open-tags/opentag-U1/hardware/v2_final_part_list.csv

Comment | Designator | Footprint | JLCPCB Part # | Qty | Ext.Price($)
LED | D14,D5,D7,D8,D9 | 0402 | C965793 | 62 | 0.49
AP2112K-3.3 | U4 | SOT-23-5 | C23380830 | 12 | 1.29
Si2319CDS | Q1 | SOT-23 | C5122036 | 12 | 1.11
511k | R5 | 0402 | C64042 | 20 | 0.02
SW_Push | SW1,SW2 | SW_SPST_EVQP2_ShortPushTravel_H2.1mm | C79161 | 20 | 7.51
BZT52Bxx | D13 | D_SOD-123F | C282531 | 14 | 0.63
105k | R4 | 0402 | C25742 | 20 | 0.01
LED | D15 | 0402 | C25503345 | 22 | 0.18
LED | D10 | 0402 | C25503856 | 20 | 0.26
Conn_ARM_JTAG_SWD_10 | J1 | PinHeader_2x05_P1.27mm_Vertical_SMD | C42372555 | 10 | 1.91
22u | C10,C9 | 0402 | C3845593 | 21 | 2.95
LED | D11,D12 | 0402 | C20613596 | 32 | 0.36
SP0503BAHTG | D2 | SOT-143 | C3040626 | 12 | 1.13
10u | C16,C3 | 0402 | C315248 | 32 | 0.29
120 | R20 | 0402 | C25079 | 20 | 0.02
10u | L1 | L_Sunlord_MWSA0503S | C408412 | 12 | 2.03
75p | C11 | 0402 | C107010 | 20 | 0.02
TPS54302 | U3 | SOT-23-6 | C311983 | 10 | 2.44
USB_C_Receptacle_USB2.0_16P | J3 | USB_C_Receptacle_XKB_U262-16XN-4BVC11 | C319148 | 10 | 3.70
SS14 | D3,D4 | D_SMA | C2480 | 30 | 0.50
100k | R3,R7,R9 | 0402 | C25530 | 40 | 0.03
1k | R10,R11,R12,R13,R14,R15,R16,R17,R21,R22 | 0402 | C11702 | 110 | 0.11
1u | C4,C7,C8 | 0402 | C1518208 | 34 | 1.03
49.9 | R6 | 0402 | C325388 | 20 | 0.05
13.3k | R8 | 0402 | C122547 | 20 | 0.02
5.1k | R1,R2 | 0402 | C25905 | 30 | 0.03
SW_Push | SW3 | THS101J | C2758165 | 10 | 5.99
Crystal_GND24 | Y2 | Crystal_SMD_Abracon_ABM3B-4Pin_5.0x3.2mm | C276420 | 10 | 6.18
14p | C12,C13 | 0402 | C458857 | 30 | 0.06
TCAN1044VDRQ1 | U1 | SOIC-8_3.9x4.9mm_P1.27mm | C1852061 | 10 | 3.39
100n | C17,C21,C5,C6,C14,C15,C18,C19,C2,C20 | 0402 | C307331 | 110 | 0.46
10k | R18,R19 | 0402 | C25744 | 30 | 0.04
STM32G474CCTx | U5 | LQFP-48_7x7mm_P0.5mm | C730124 | 10 | 29.39
