open-tags/opentag-U1/mechanical/opentag_one_v2_full_assembly.step

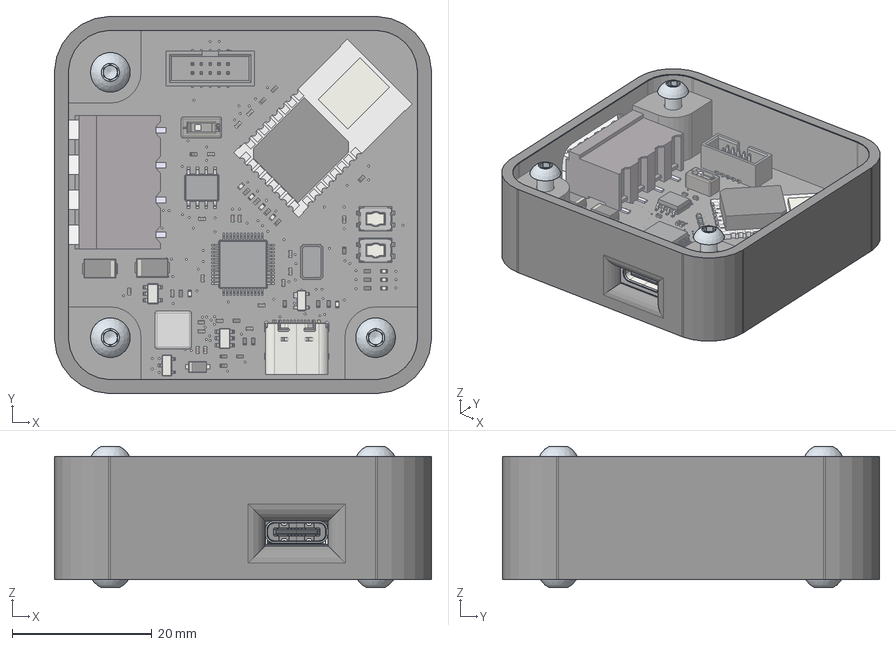
[picture p2: CAD file, 2026-10-29]
mechanical/opentag_one_v2_full_assembly.step
54.0 x 54.0 x 20.2 mm
USB_C_Receptacle_GCT_USB4105-xx-A_16P_TopMnt_Horizontal x 36
DWM1000
C_0402_1005Metric_1
R_0402_1005Metric_11
v2 1.28.1 x 3
SOT-23-5
802-2195SM-XXG_3
802-2195SM-XXG_9
C_0402_1005Metric_11
C_0402_1005Metric
SOT-143
1473790000--3DModel-STEP-764301 x 13
C_0402_1005Metric_9
802-2195SM-XXG_7
opentag_PCB
M3 Threaded Insert x 3
C_0402_1005Metric_18
Socket button head screw M3x0.5 x 6 x 3
D_SMA
C_0402_1005Metric_5
C_0402_1005Metric_2
v2_lid x 2
C_0402_1005Metric_10
Socket button head screw M3x0.5 x 10 x 3
C_0402_1005Metric_15
802-2195SM-XXG_2
SW_SPST_EVQP2_ShortPushTravel_H2.1mm_1
LED_0402_1005Metric_6
802-2195SM-XXG
R_0402_1005Metric
C_0402_1005Metric_14
v2_case
R_0402_1005Metric_17
R_0402_1005Metric_6
C_0402_1005Metric_3
R_0402_1005Metric_4
SOT-23
C_0402_1005Metric_4
LED_0402_1005Metric
R_0402_1005Metric_7
R_0402_1005Metric_20
R_0402_1005Metric_21
802-2195SM-XXG_1
C_0402_1005Metric_8
C_0402_1005Metric_19
R_0402_1005Metric_12
R_0402_1005Metric_14
R_0402_1005Metric_15
802-2195SM-XXG_6
D_SOD-123F
LED_0402_1005Metric_3
SOIC-8_3.9x4.9mm_P1.27mm
v2 - dip_switch
C_0402_1005Metric_7
LQFP-48_7x7mm_P0.5mm
R_0402_1005Metric_3
LED_0402_1005Metric_5
802-2195SM-XXG_5
SOT-23-6
R_0402_1005Metric_8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
