open-tags/opentag-U1/mechanical/opentag_one_v2_case.step

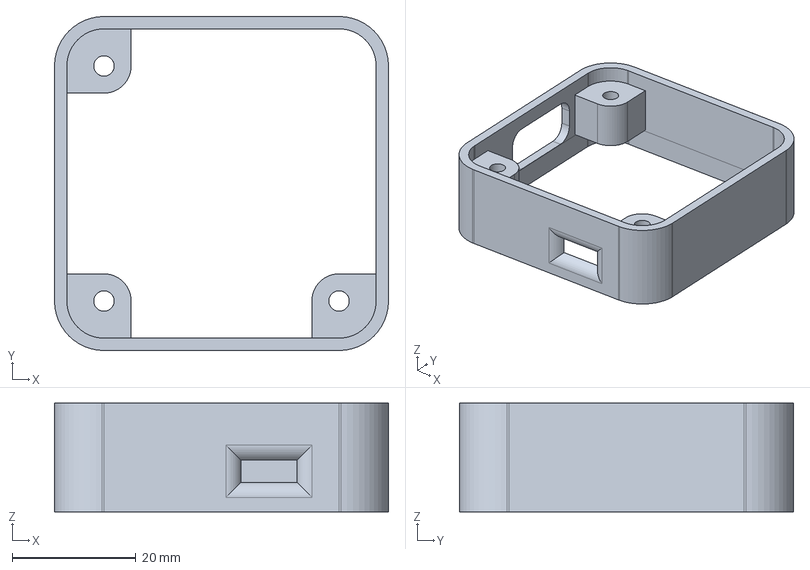
[picture p3: CAD file, 2026-10-29]
mechanical/opentag_one_v2_case.step
54.0 x 54.0 x 17.6 mm
