open-tags/opentag-U1/mechanical/opentag_one_v2_lid.step

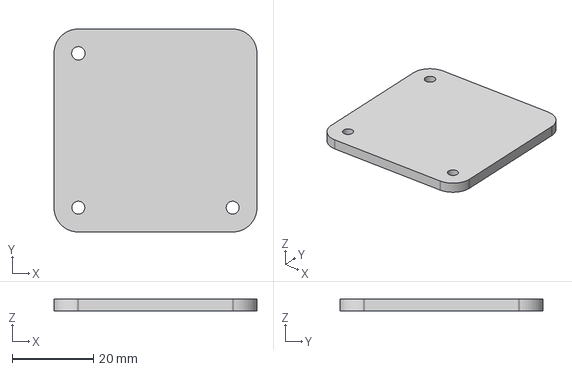
[picture p4: CAD file, 2026-10-29]
mechanical/opentag_one_v2_lid.step
50.0 x 50.0 x 3.00 mm
