open-tags/opentag-U1/(list of files, cad)

Other CAD files:
mechanical/opentag_one_v2_case.3mf
