open-tags/opentag-U1/hardware/opentag-schematic.pdf

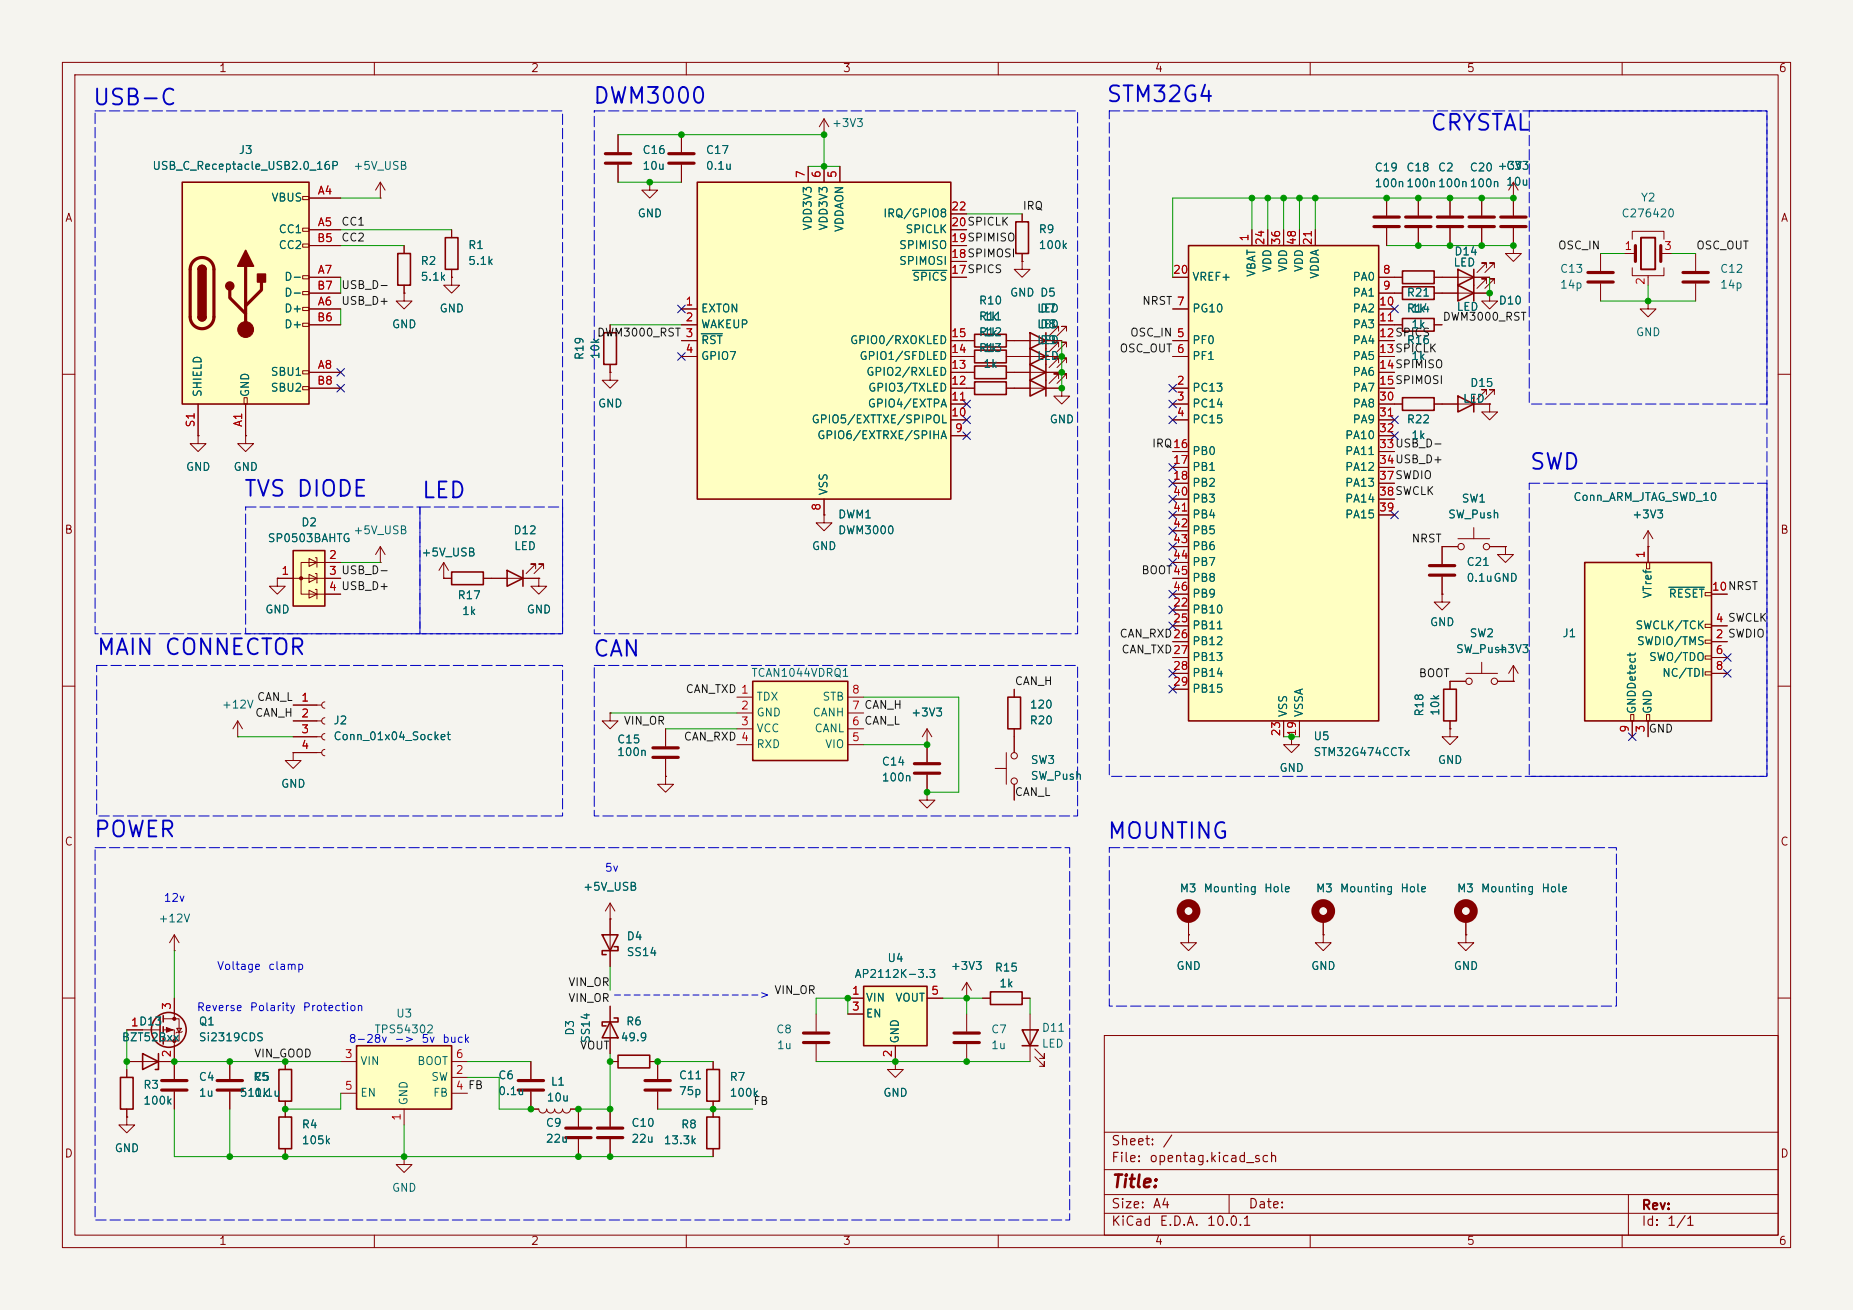
[picture p5: page 1]

SPICS 17 SPIMOSI 18 SPIMISO 19 SPICLK 20 IRQ/GPIO8 22 DWM1 DWM3000 R8

8 GPIO6/EXTRXE/SPIHA 9 GPIO5/EXTTXE/SPIPOL 10 GPIO4/EXTPA 11 GPIO3/TXLED 12 GPIO2/RXLED 13 GPIO1/SFDLED 14 GPIO0/RXOKLED 15

Reverse Polarity Protection 12v POWER

GND M3 Mounting Hole GND

Size: A4 | Rev:
KiCad E.D.A. 10.0.1 | Id: 1/1
