open-tags/opentag-U1/hardware/opentag.kicad_pcb

## KiCad design hardware/opentag.kicad_pcb (2026-10-29)

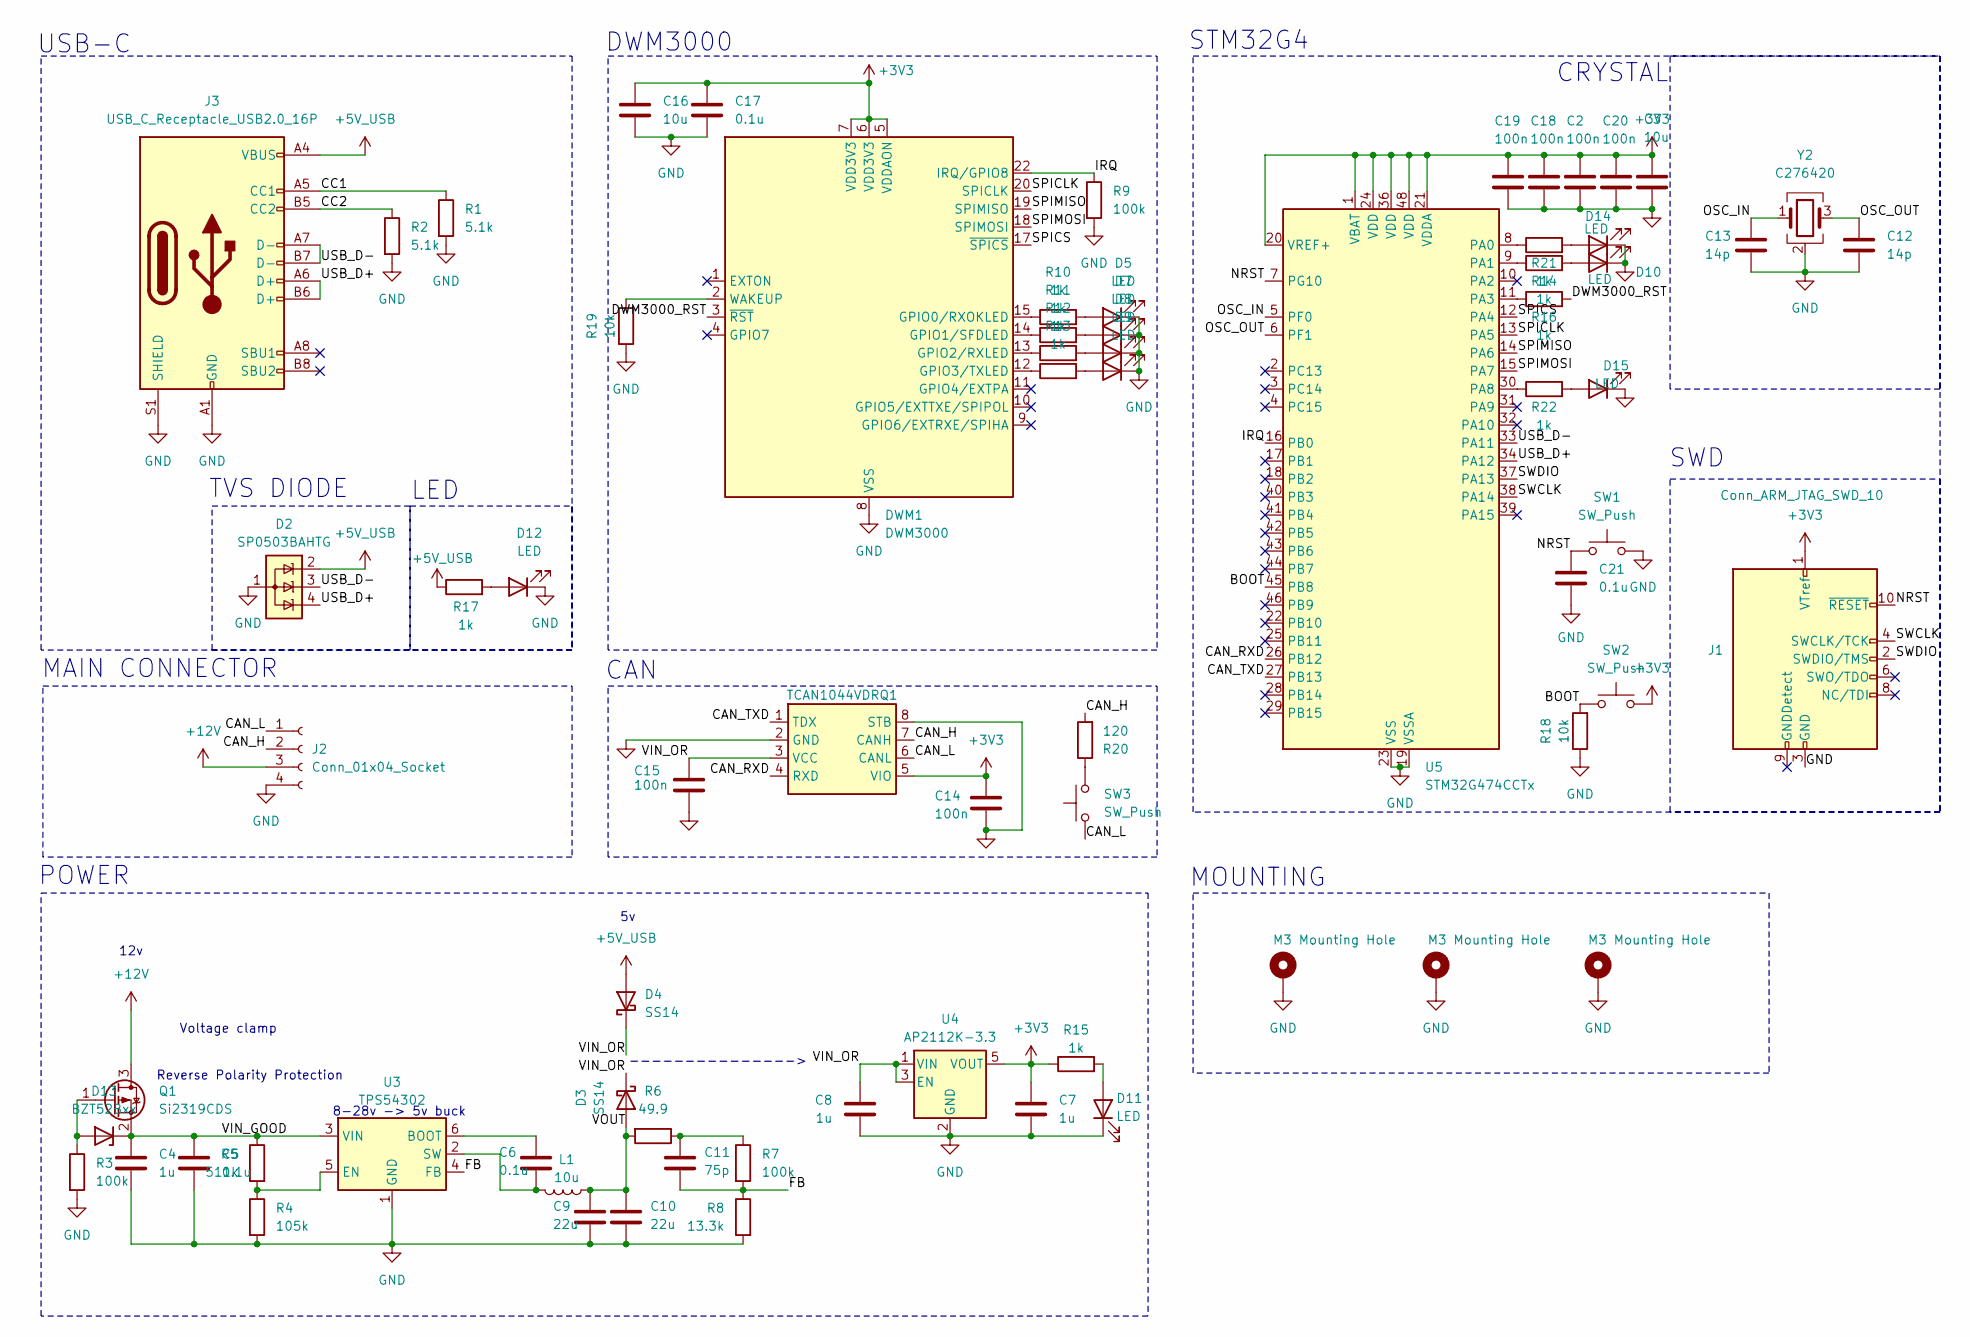
[picture p6: schematic opentag.kicad_sch]

Parts:
C2, C14, C15, C18, C19, C20: 100n; C_0402_1005Metric_Pad0.74x0.62mm_HandSolder; LCSC C307331
C3, C16: 10u; C_0402_1005Metric_Pad0.74x0.62mm_HandSolder; LCSC C315248
C4, C8: 1u; C_0402_1005Metric_Pad0.74x0.62mm_HandSolder; LCSC C1518208
C5, C6, C17, C21: 0.1u; C_0402_1005Metric_Pad0.74x0.62mm_HandSolder; LCSC C307331
C7: 1u; C_0402_1005Metric_Pad0.74x0.62mm_HandSolder; LCSC C29266
C9, C10: 22u; C_0402_1005Metric_Pad0.74x0.62mm_HandSolder; LCSC C105226
C11: 75p; C_0402_1005Metric_Pad0.74x0.62mm_HandSolder; LCSC C107010
C12, C13: 14p; C_0402_1005Metric_Pad0.74x0.62mm_HandSolder; LCSC C458857
D2: SP0503BAHTG; SOT-143; LCSC C3040626
D3, D4: SS14; D_SMA; LCSC C2480
D5, D7, D8, D9, D10, D11, D12, D14, D15: LED; LED_0402_1005Metric_Pad0.77x0.64mm_HandSolder; LCSC C130719
D13: BZT52Bxx; D_SOD-123F; LCSC C282531
DWM1: DWM3000; DWM1000; Mouser Part Number 772-DWM3000TR13; Digikey Part Number 2312-DWM3000TR13CT-ND
H1, H2, H3: M3 Mounting Hole; MountingHole_3.2mm_M3_Pad_Via
J1: Conn_ARM_JTAG_SWD_10; PinHeader_2x05_P1.27mm_Vertical_SMD; LCSC C42372555
J2: Conn_01x04_Socket; 4_WIRE_1473790000; Mouser Part Number 470-1473790000; Digikey Part Number 281-6806-1-ND
J3: USB_C_Receptacle_USB2.0_16P; USB_C_Receptacle_XKB_U262-16XN-4BVC11; LCSC C319148
L1: 10u; L_Sunlord_MWSA0503S; LCSC C408412
Q1: Si2319CDS; SOT-23; LCSC C5122036
R1, R2: 5.1k; R_0402_1005Metric_Pad0.72x0.64mm_HandSolder; LCSC C25905
R3, R7, R9: 100k; R_0402_1005Metric_Pad0.72x0.64mm_HandSolder; LCSC C25530
R4: 105k; R_0402_1005Metric_Pad0.72x0.64mm_HandSolder; LCSC C25742
R5: 511k; R_0402_1005Metric_Pad0.72x0.64mm_HandSolder; LCSC C64042
R6: 49.9; R_0402_1005Metric_Pad0.72x0.64mm_HandSolder; LCSC C325388
R8: 13.3k; R_0402_1005Metric_Pad0.72x0.64mm_HandSolder; LCSC C122547
R10, R11, R12, R13, R14, R15, R16, R17, R21, R22: 1k; R_0402_1005Metric_Pad0.72x0.64mm_HandSolder; LCSC C11702
R18, R19: 10k; R_0402_1005Metric_Pad0.72x0.64mm_HandSolder; LCSC C25744
R20: 120; R_0402_1005Metric_Pad0.72x0.64mm_HandSolder; LCSC C100218
SW1, SW2: SW_Push; SW_SPST_EVQP2_ShortPushTravel_H2.1mm; LCSC C79161
SW3: SW_Push; THS101J; LCSC C2758165
U1: TCAN1044VDRQ1; SOIC-8_3.9x4.9mm_P1.27mm; LCSC C1852061
U3: TPS54302; SOT-23-6; LCSC C311983
U4: AP2112K-3.3; SOT-23-5; LCSC C23380830
U5: STM32G474CCTx; LQFP-48_7x7mm_P0.5mm; LCSC C730124
Y2: C276420; Crystal_SMD_Abracon_ABM3B-4Pin_5.0x3.2mm; LCSC C276420

Connections:
+3V3: C2.1, C3.1, C7.1, C14.1, C16.1, C17.1, C18.1, C19.1, C20.1, DWM1.5 (VDDAON), DWM1.6 (VDD3V3), DWM1.7 (VDD3V3), J1.1 (VTref), R15.1, SW2.2, U1.5 (VIO), U4.5 (VOUT), U5.1 (VBAT), U5.20 (VREF+), U5.21 (VDDA), U5.24 (VDD), U5.36 (VDD), U5.48 (VDD)
+5V_USB: D2.2 (K), D4.2 (A), J3.A4 (VBUS), J3.A9 (VBUS), J3.B4 (VBUS), J3.B9 (VBUS), R17.1
+12V: J2.3, Q1.3 (D)
/BOOT: R18.2, SW2.1, U5.45 (PB8)
/CAN_H: J2.2, R20.2, U1.7 (CANH)
/CAN_L: J2.1, SW3.1, U1.6 (CANL)
/CAN_RXD: U1.4 (RXD), U5.26 (PB12)
/CAN_TXD: U1.1 (TDX), U5.27 (PB13)
/CC1: J3.A5 (CC1), R1.1
/CC2: J3.B5 (CC2), R2.1
/DWM3000_RST: DWM1.3 (~RST), R16.2
/FB: C11.2, R7.2, R8.1, U3.4 (FB)
/IRQ: DWM1.22 (IRQ/GPIO8), R9.1, U5.16 (PB0)
/NRST: C21.1, J1.10 (~RESET), SW1.1, U5.7 (PG10)
/OSC_IN: C13.1, U5.5 (PF0), Y2.1
/OSC_OUT: C12.1, U5.6 (PF1), Y2.3
/SPICLK: DWM1.20 (SPICLK), U5.13 (PA5)
/SPICS: DWM1.17 (~SPICS), U5.12 (PA4)
/SPIMISO: DWM1.19 (SPIMISO), U5.14 (PA6)
/SPIMOSI: DWM1.18 (SPIMOSI), U5.15 (PA7)
/SWCLK: J1.4 (SWCLK/TCK), U5.38 (PA14)
/SWDIO: J1.2 (SWDIO/TMS), U5.37 (PA13)
/USB_D+: D2.4 (K), J3.A6 (D+), J3.B6 (D+), U5.34 (PA12)
/USB_D-: D2.3 (K), J3.A7 (D-), J3.B7 (D-), U5.33 (PA11)
/VIN_GOOD: C4.1, C5.1, D13.1 (K), Q1.2 (S), R5.1, U3.3 (VIN)
/VIN_OR: C8.1, C15.1, D3.1 (K), D4.1 (K), U1.3 (VCC), U4.1 (VIN), U4.3 (EN)
/VOUT: C9.1, C10.1, D3.2 (A), L1.1, R6.2
GND: C2.2, C3.2, C4.2, C5.2, C7.2, C8.2, C9.2, C10.2, C12.2, C13.2, C14.2, C15.2, C16.2, C17.2, C18.2, C19.2, C20.2, C21.2, D2.1 (A), D5.1 (K), D7.1 (K), D8.1 (K), D9.1 (K), D10.1 (K), D11.1 (K), D12.1 (K), D14.1 (K), D15.1 (K), DWM1.8 (VSS), DWM1.16 (VSS), DWM1.21 (VSS), DWM1.23 (VSS), DWM1.24 (VSS), H1.1 (1_1), H2.1 (1_1), H3.1 (1_1), J1.3 (GND), J1.5 (GND), J2.4, J3.A1 (GND), J3.A12 (GND), J3.B1 (GND), J3.B12 (GND), J3.S1 (SHIELD), R1.2, R2.2, R3.2, R4.2, R8.2, R9.2, R18.1, R19.1, SW1.2, U1.2 (GND), U1.8 (STB), U3.1 (GND), U4.2 (GND), U5.19 (VSSA), U5.23 (VSS), U5.35 (VSS), U5.47 (VSS), Y2.2 (G), Y2.4 (G)
unnamed: C11.1, R6.1, R7.1
unnamed: D5.2 (A), R10.2
unnamed: D7.2 (A), R11.2
unnamed: D8.2 (A), R12.2
unnamed: D9.2 (A), R13.2
unnamed: D10.2 (A), R14.2
unnamed: D11.2 (A), R15.2
unnamed: D12.2 (A), R17.2
unnamed: D13.2 (A), Q1.1 (G), R3.1
unnamed: D14.2 (A), R21.2
unnamed: D15.2 (A), R22.2
unnamed: DWM1.15 (GPIO0/RXOKLED), R10.1
unnamed: DWM1.14 (GPIO1/SFDLED), R11.1
unnamed: DWM1.13 (GPIO2/RXLED), R12.1
unnamed: DWM1.12 (GPIO3/TXLED), R13.1
unnamed: DWM1.2 (WAKEUP), R19.2
unnamed: R20.1, SW3.2
unnamed: C6.1, U3.6 (BOOT)
unnamed: R4.1, R5.2, U3.5 (EN)
unnamed: C6.2, L1.2, U3.2 (SW)
unnamed: R21.1, U5.8 (PA0)
unnamed: R14.1, U5.9 (PA1)
unnamed: R16.1, U5.11 (PA3)
unnamed: R22.1, U5.30 (PA8)

Notes on the sheet:
MOUNTING
SWD
LED
DWM3000
TVS DIODE
--------------->
Reverse Polarity Protection
8-28v -> 5v buck
Voltage clamp
CAN
POWER
USB-C
12v
STM32G4
CRYSTAL
MAIN CONNECTOR

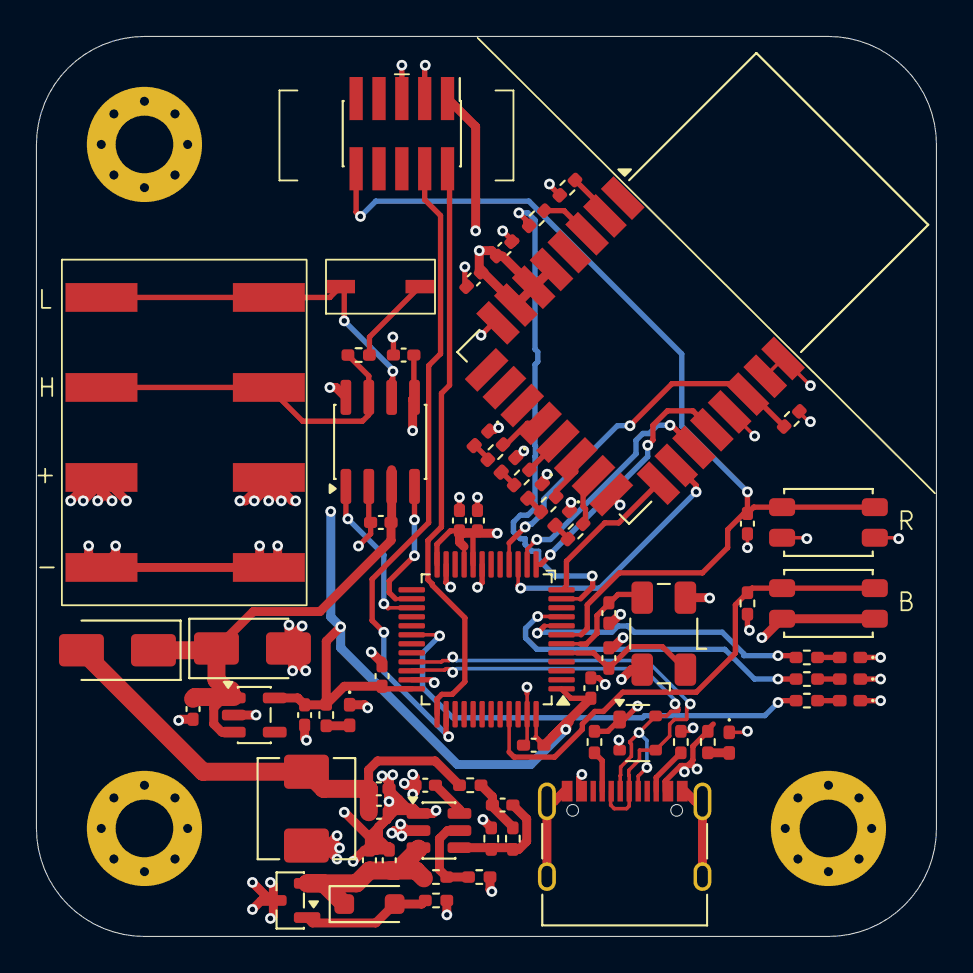
[picture p7: board opentag.kicad_pcb from above]

Board: 4 copper layers, 50.0 x 50.0 mm, 72 parts (0 on the bottom side), 52 nets.
